DanielaS99/Biomag/Plans/Schematic.png

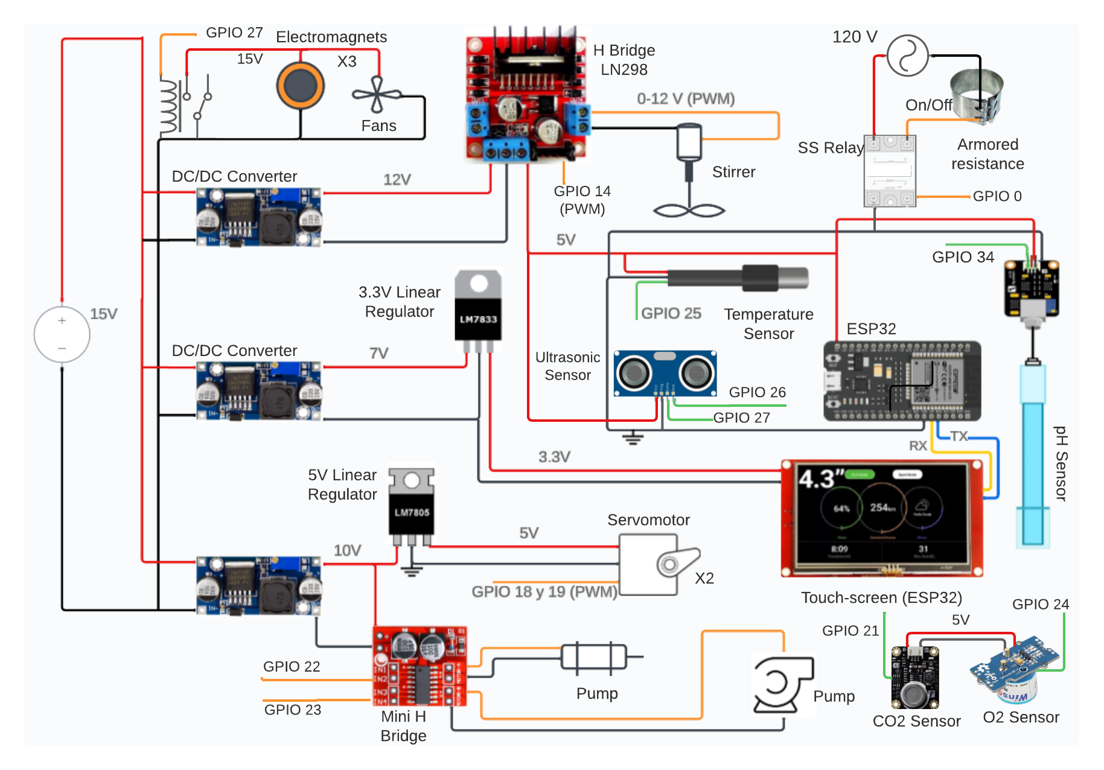
Plans/Schematic.png
