DanielaS99/Biomag/Plans/Coupling.pdf

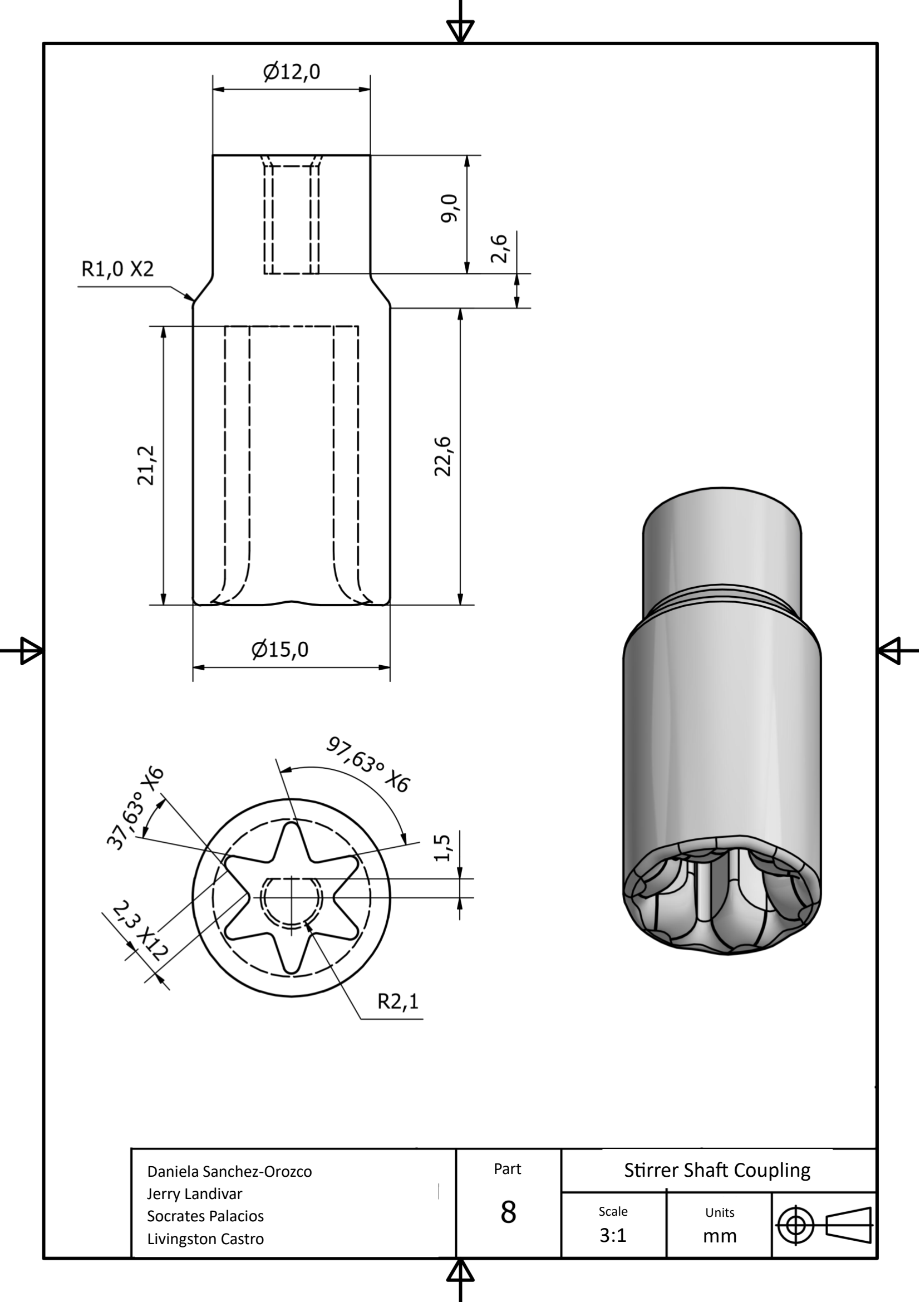
[picture p2: page 1]

Daniela Sanchez

-Orozco
Jerry Landivar
Socrates Palacios
Livingston Castro
Part | Stirrer Shaft Coupling
| Scale 3:1 Units mm
