DanielaS99/Biomag/Plans/Rack_Casing.pdf

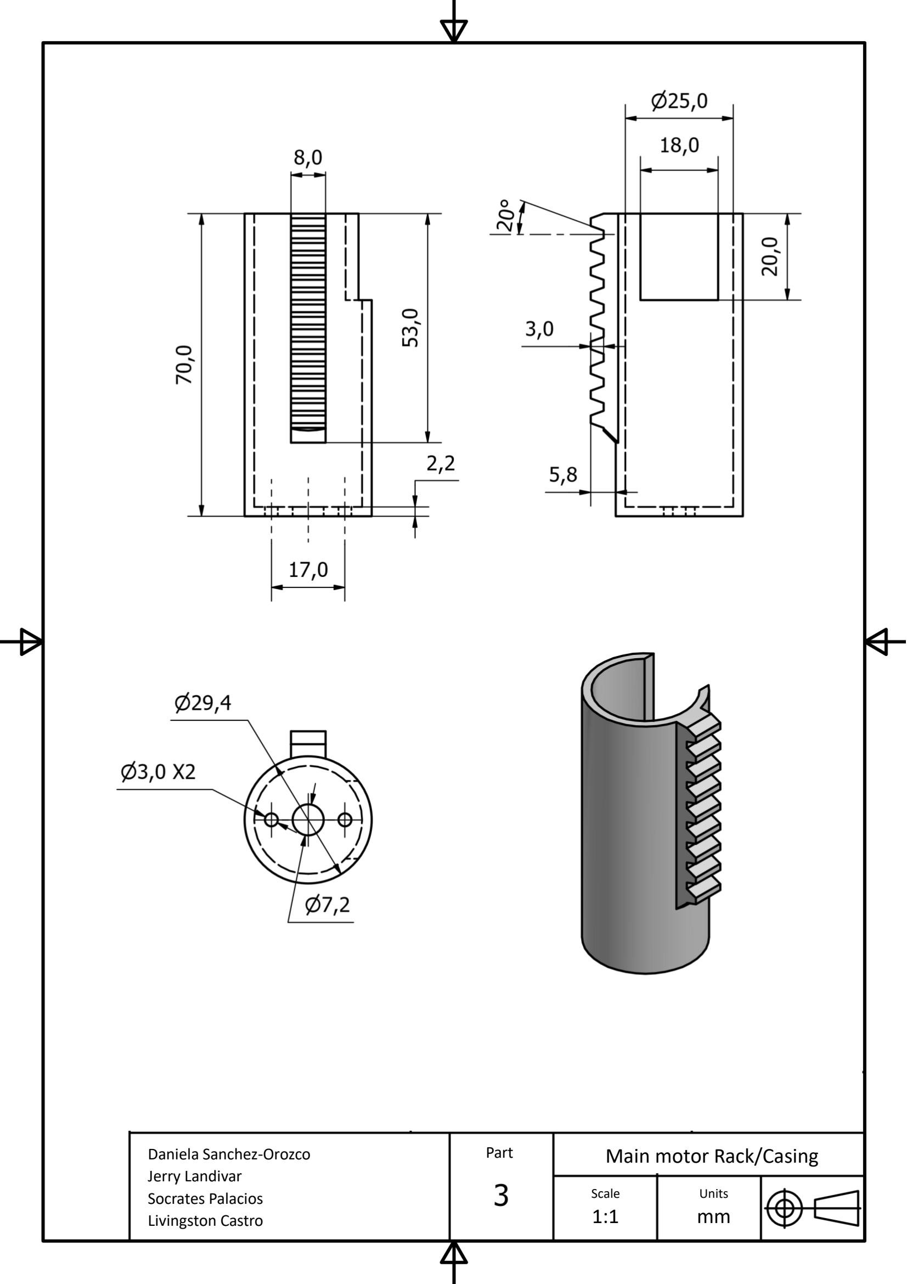
[picture p3: page 1]

Daniela Sanchez

-Orozco
Jerry Landivar
Socrates Palacios
Livingston Castro
Part | Main motor Rack/Casing
| Scale 1:
| 1 Units mm
