DanielaS99/Biomag/Plans/SafetyGuard2.pdf

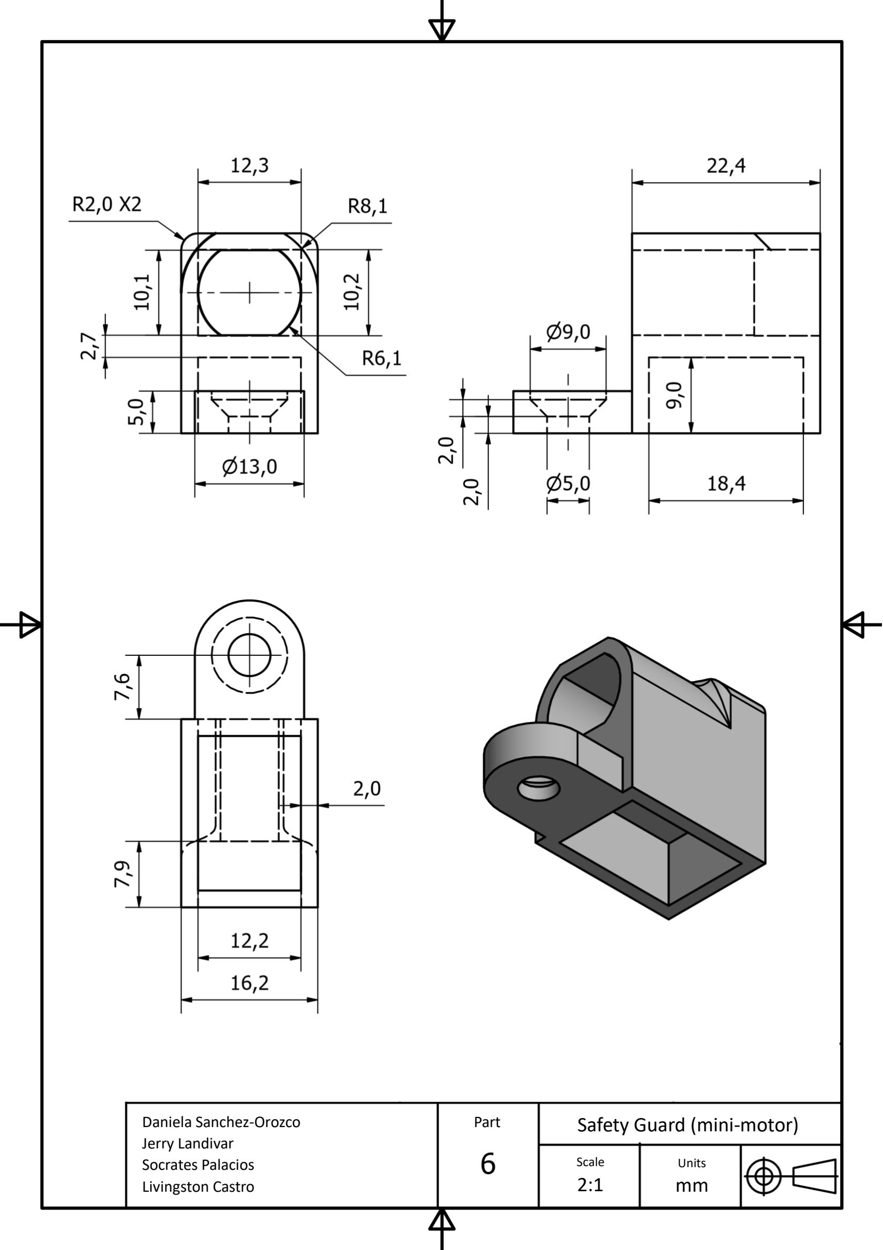
[picture p4: page 1]

Daniela Sanchez

-Orozco
Jerry Landivar
Socrates Palacios
Livingston Castro
Part | Safety Guard (mini

### -motor)

| Scale 2:1 Units mm
