DanielaS99/Biomag/Plans/ServomotorHolder.pdf

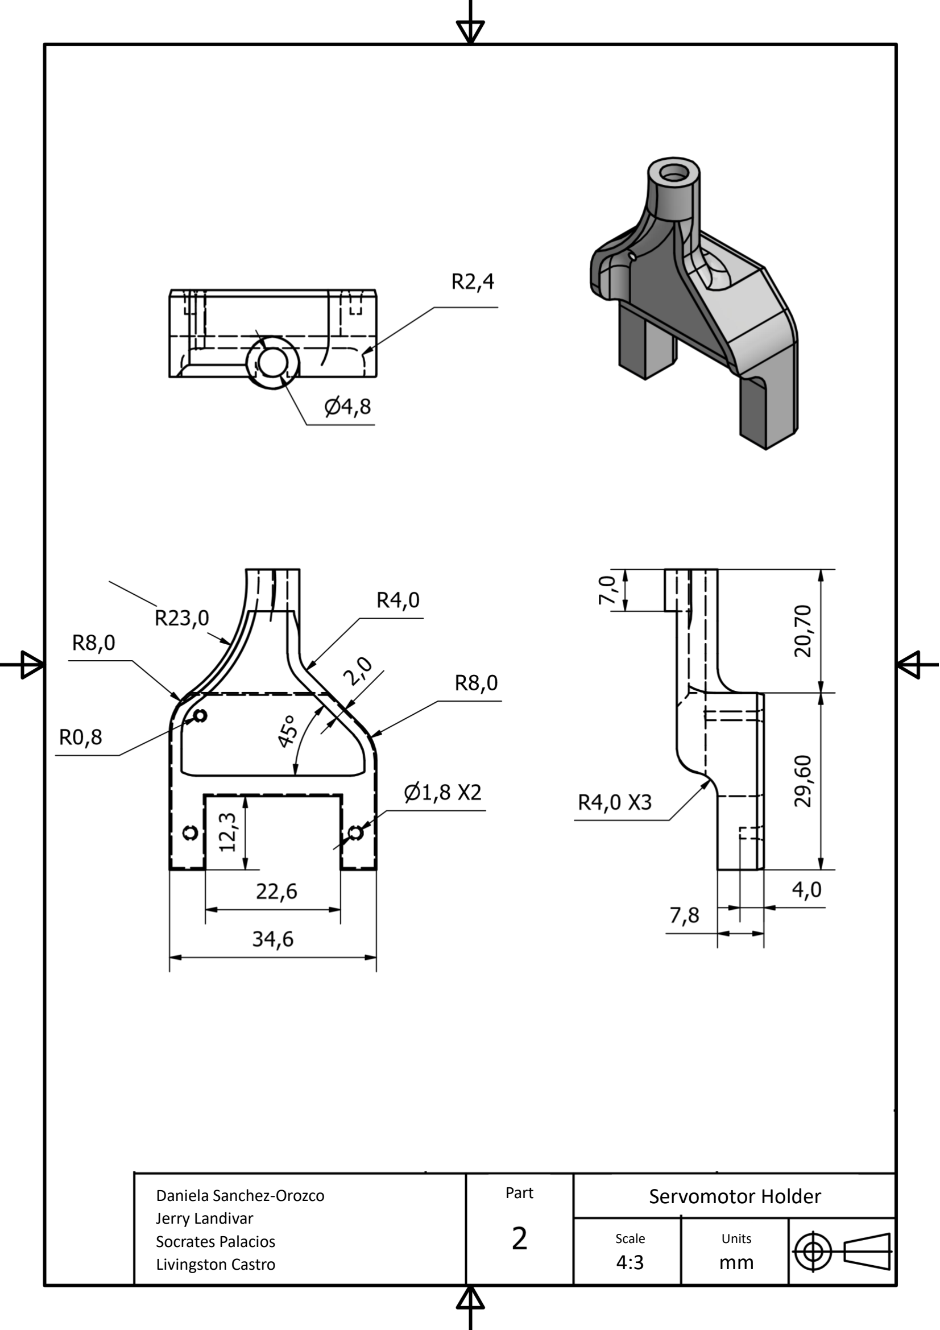
[picture p5: page 1]

Daniela Sanchez

-Orozco
Jerry Landivar
Socrates Palacios
Livingston Castro
Part | Servomotor Holder

Scale
4:3
| Units mm
