DanielaS99/Biomag/Plans/StirrerShaft.pdf

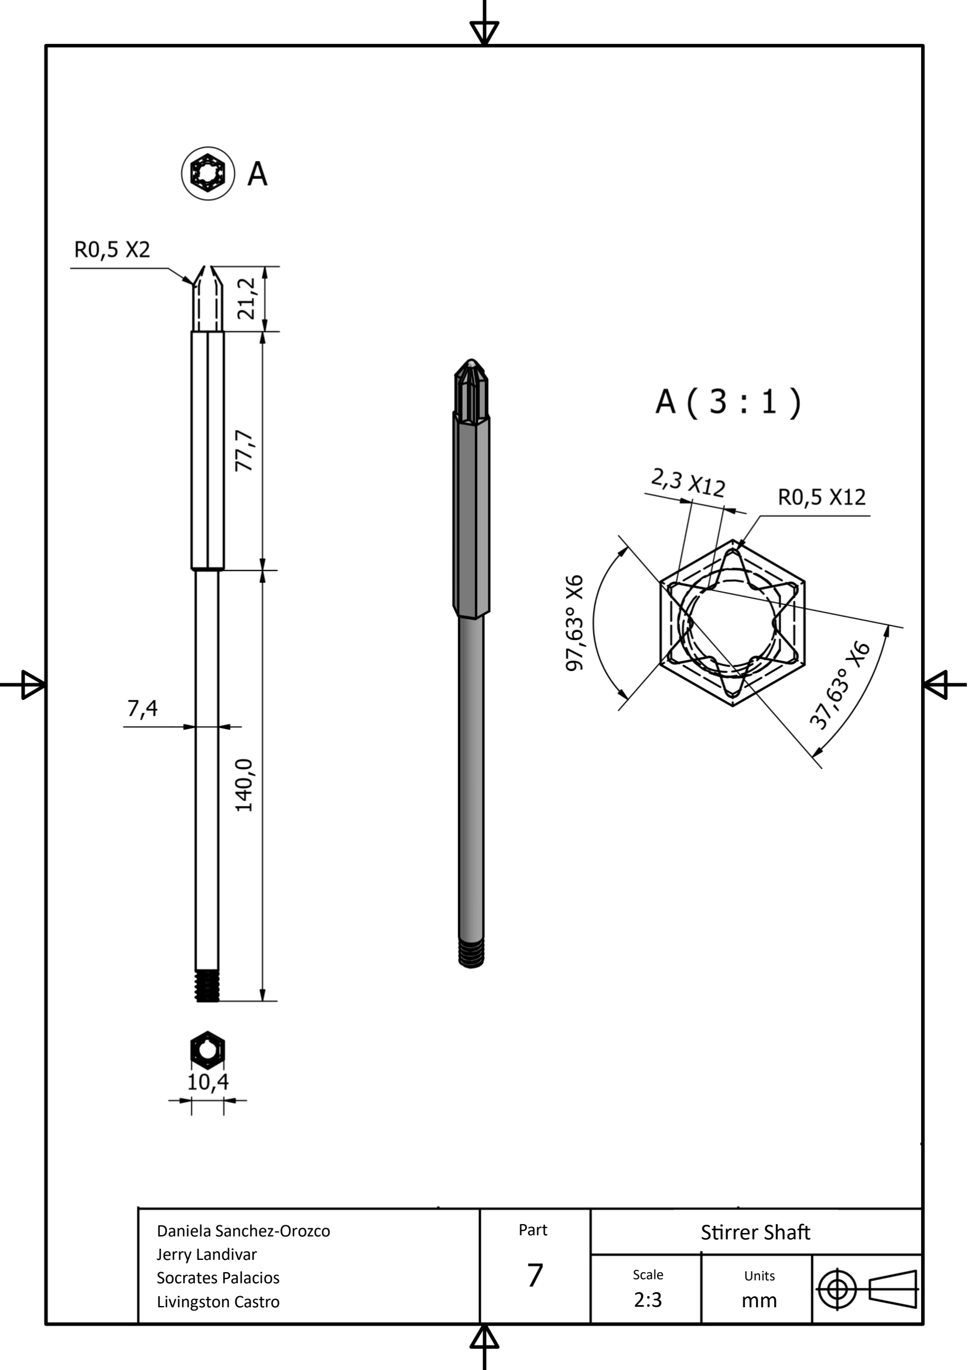
[picture p6: page 1]

Daniela Sanchez

-Orozco
Jerry Landivar
Socrates Palacios
Livingston Castro

Part

### Stirrer Shaft

Scale
2:3

Units
mm
