DanielaS99/Biomag/Plans/ThrottleCam.pdf

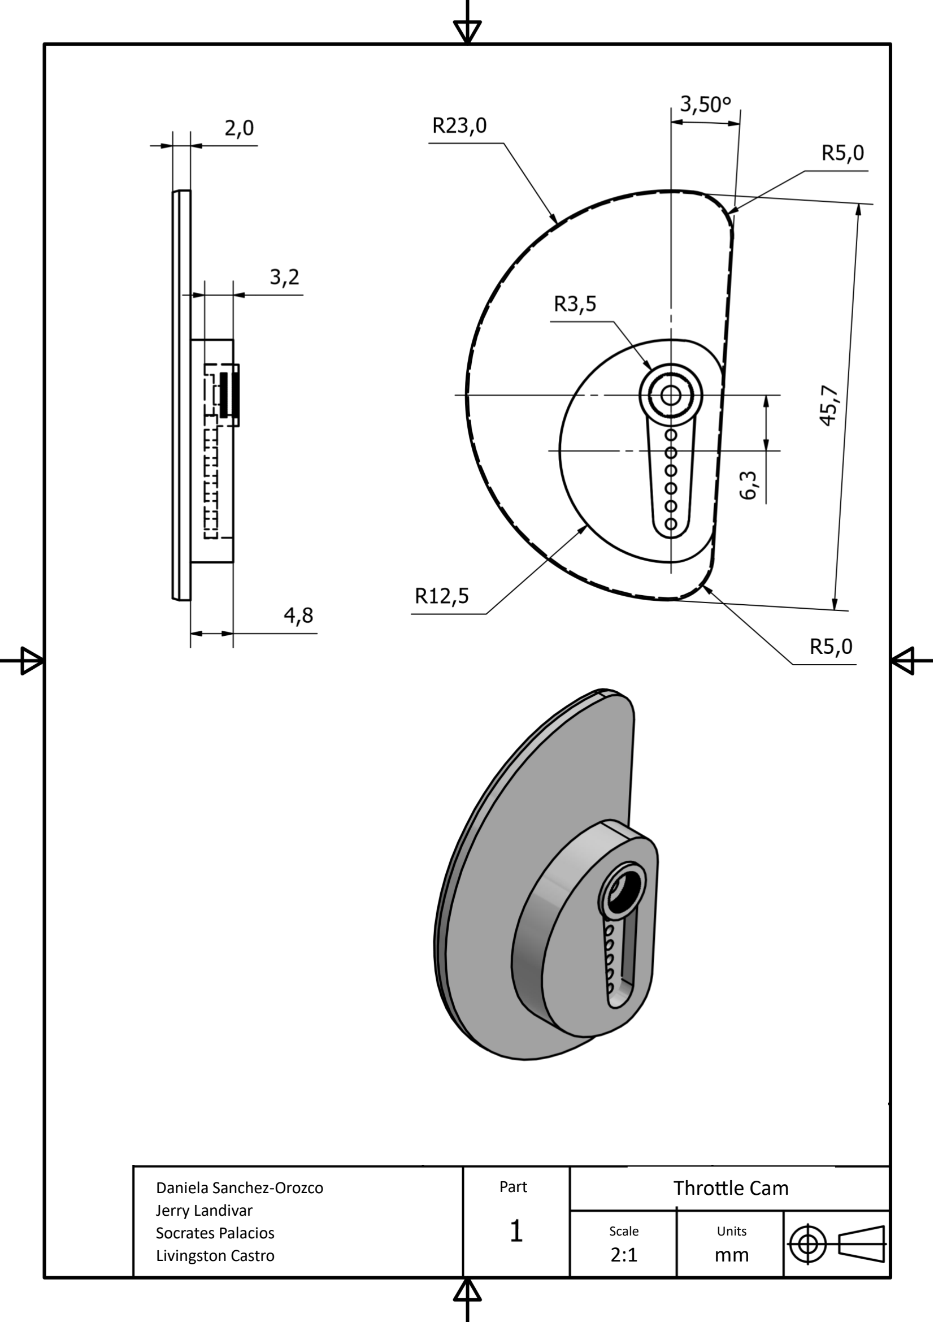
[picture p7: page 1]

Daniela Sanchez

-Orozco
Jerry Landivar
Socrates Palacios
Livingston Castro
Part | Throttle Cam

Scale
2:1
| Units mm
