DanielaS99/Biomag/Plans/Biomag1.pdf

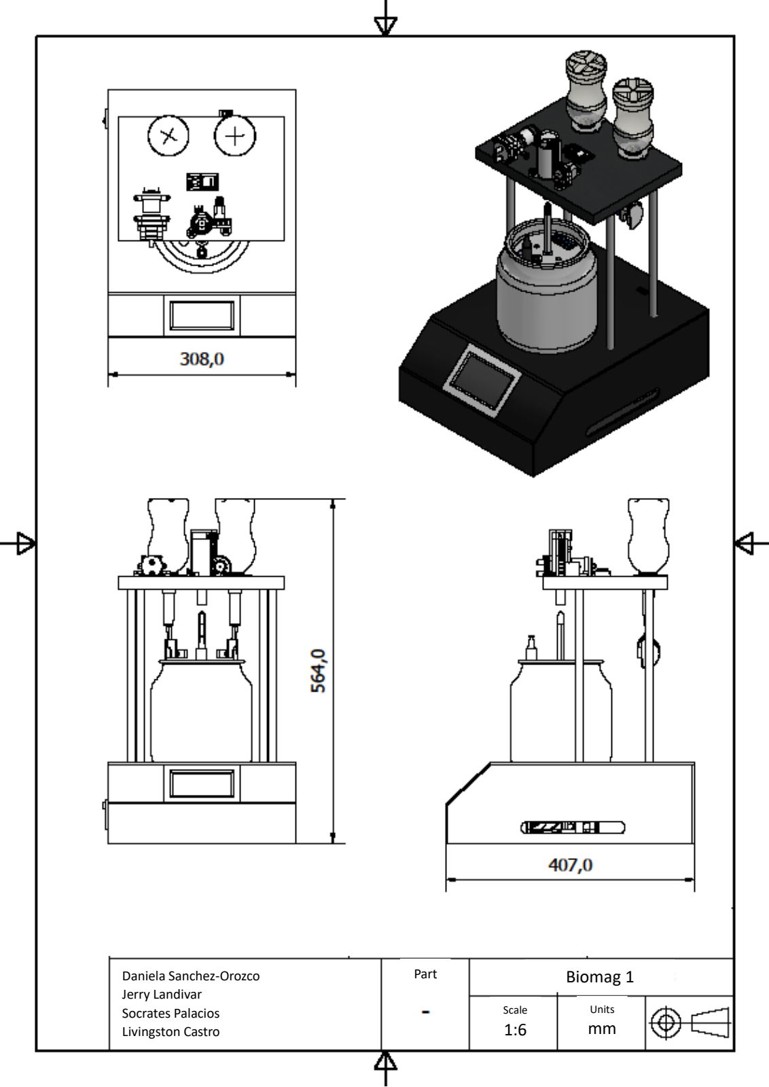
[picture p8: page 1]

Daniela Sanchez

-Orozco
Jerry Landivar
Socrates Palacios
Livingston Castro
Part | Biomag 1

Scale
1:

6

| Units mm
