DanielaS99/Biomag/Plans/Pinion.pdf

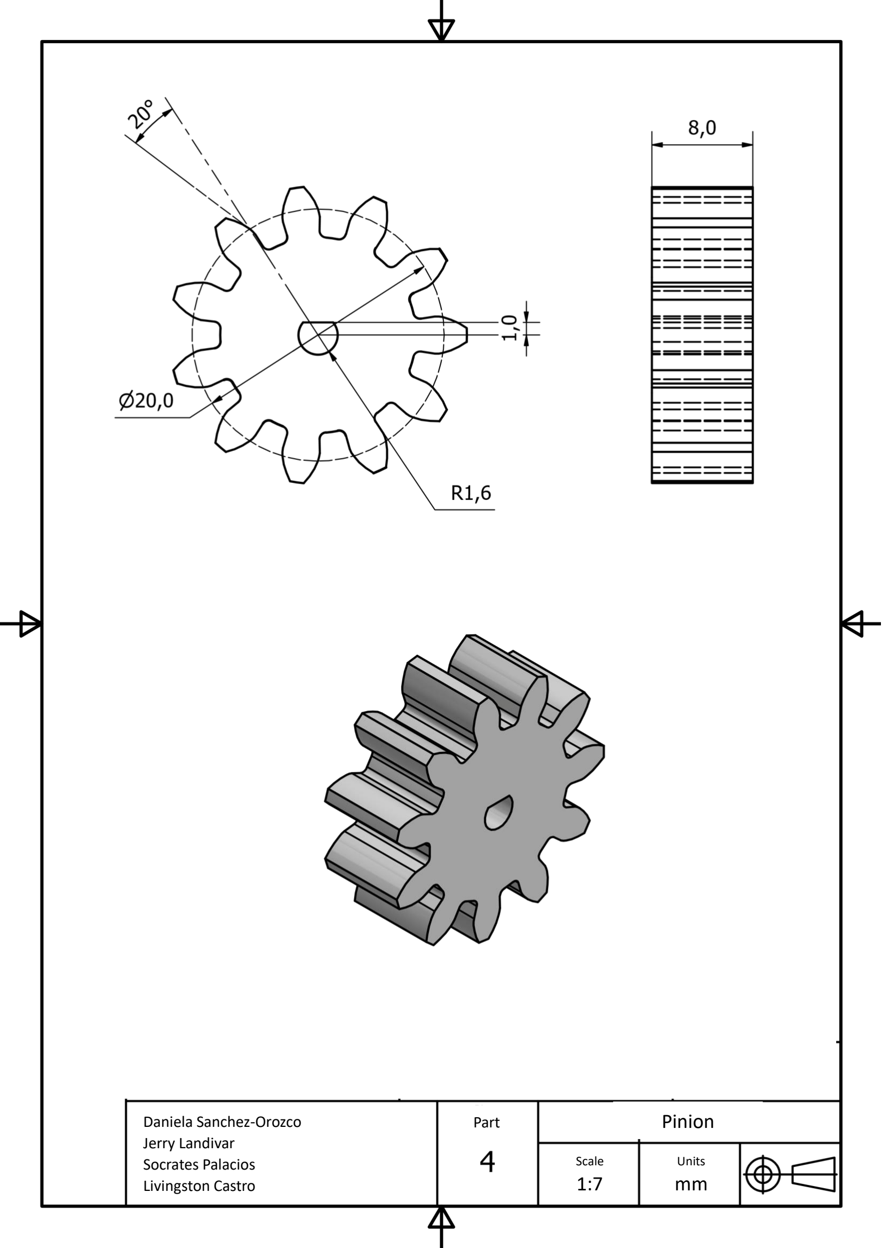
[picture p9: page 1]

Daniela Sanchez

-Orozco
Jerry Landivar
Socrates Palacios
Livingston Castro
Part | Pinion

Scale
1:7
| Units mm
