DanielaS99/Biomag/Plans/SafetyGuard1.pdf

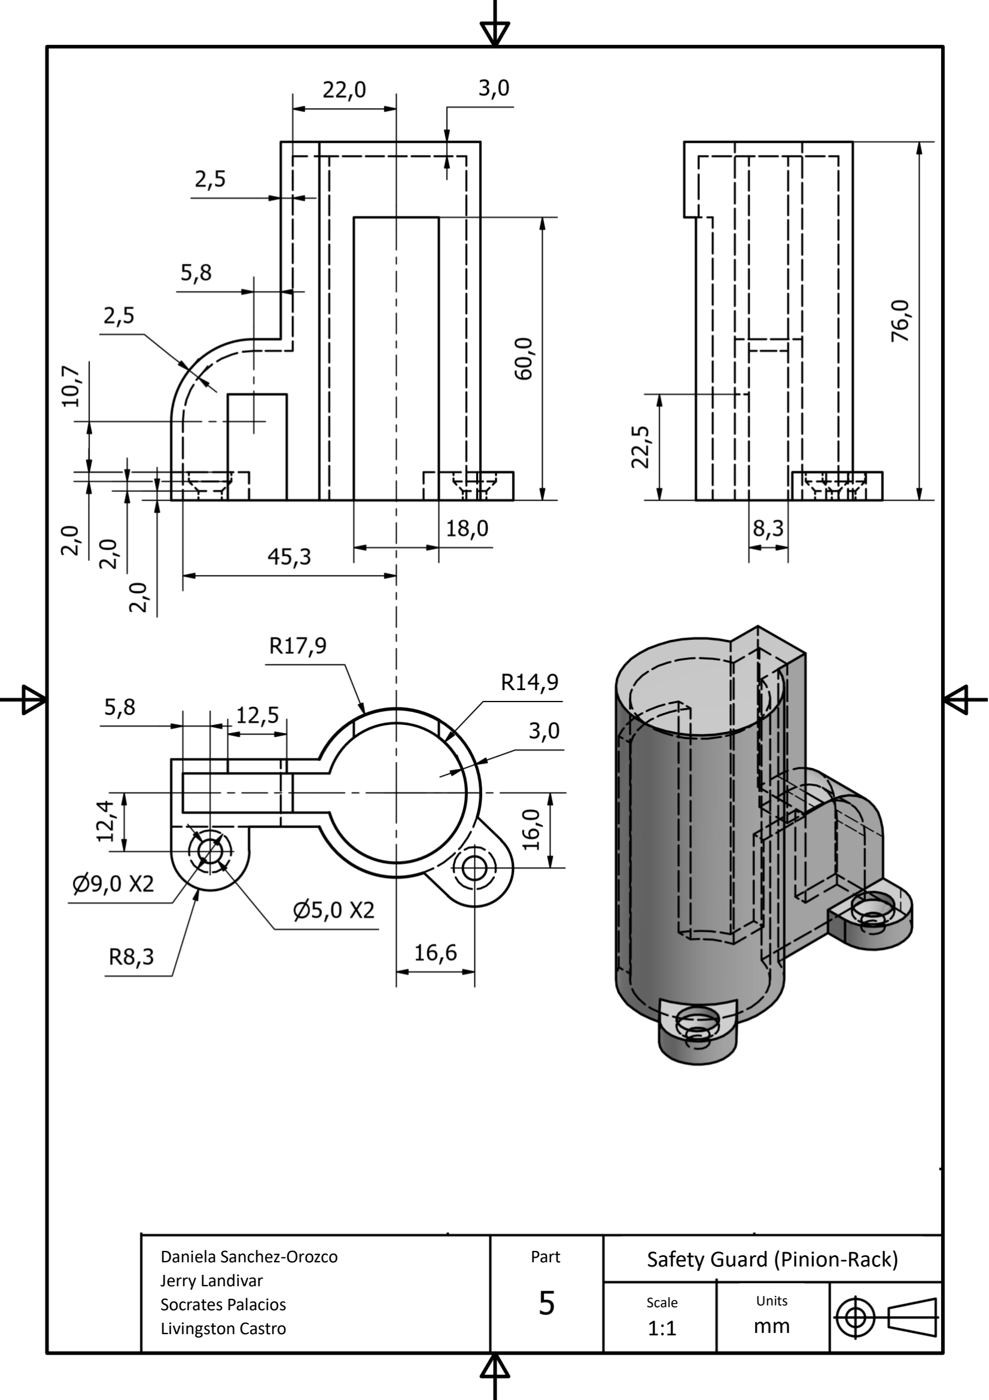
[picture p10: page 1]

Daniela Sanchez

-Orozco
Jerry Landivar
Socrates Palacios
Livingston Castro

Part

Scale
1:

1

### Safety Guard (Pinion

### -Rack)

Units
mm
