DanielaS99/Biomag/Plans/1PartList.pdf

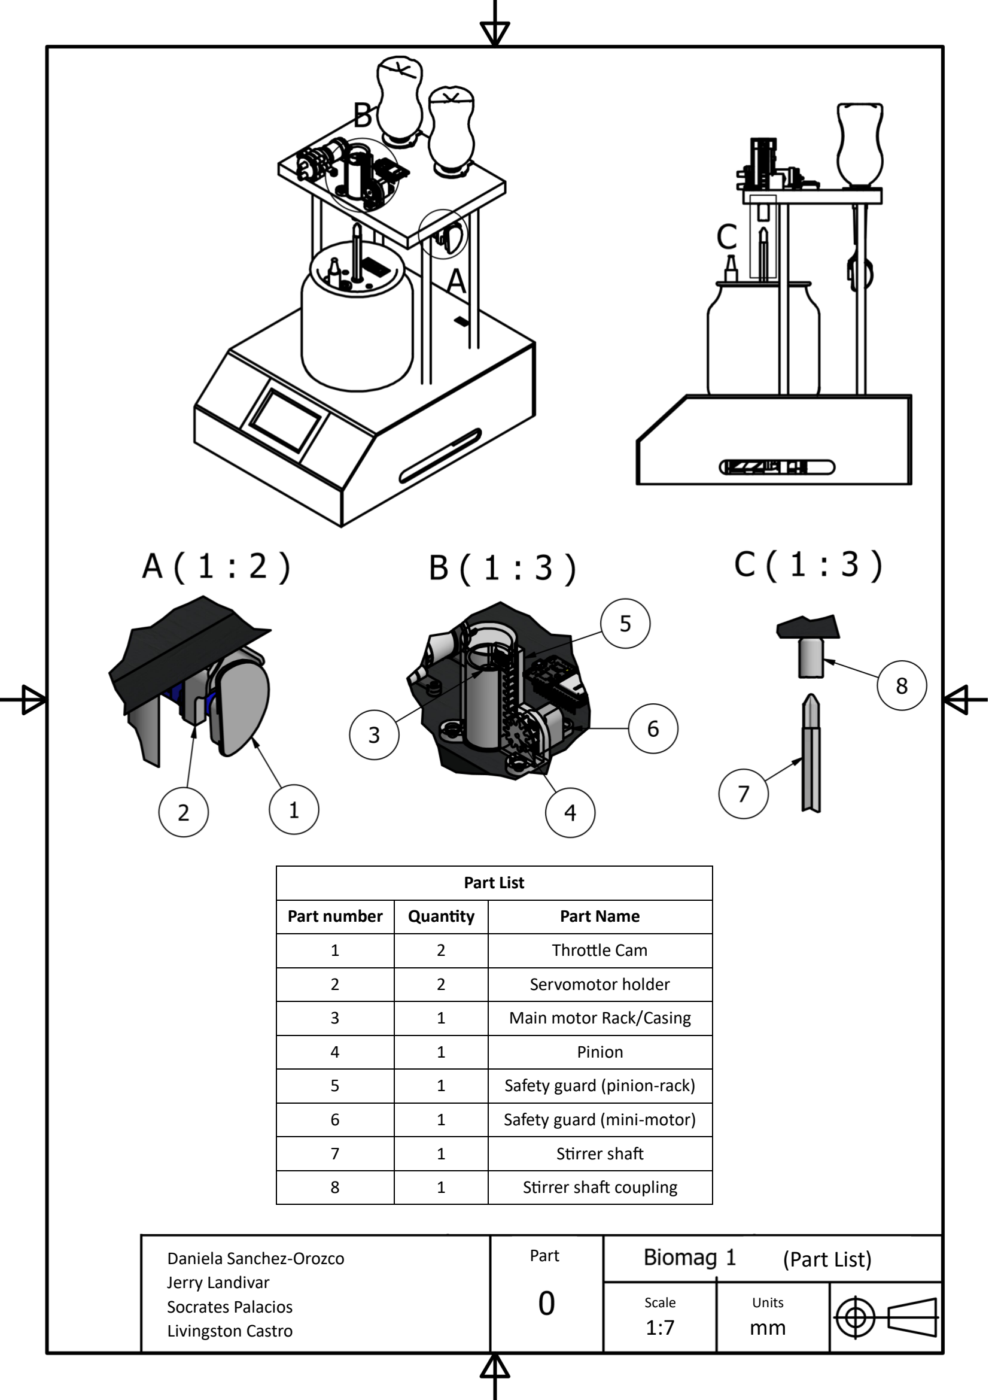
[picture p11: page 1]

Daniela Sanchez-Orozco
Jerry Landivar
Socrates Palacios
Livingston Castro

Part

Scale
1:7

Units
mm

### (Part List)

Part List

Part number | Quantity | Part Name
1 | 2 | Throttle Cam
2 | 2 | Servomotor holder
3 | 1 | Main motor Rack/Casing
4 | 1 | Pinion
5 | 1 | Safety guard (pinion-rack)
6 | 1 | Safety guard (mini-motor)
7 | 1 | Stirrer shaft
8 | 1 | Stirrer shaft coupling
