DanielaS99/Biomag/(commit log)

2024-10-21 Add files via upload
    Simulation to visualize the air flow for the electromagnets cooling system.
2024-10-21 Add files via upload
    Simulation to visualize the air flow in the electromagnet's cooling system
2024-10-22 Add files via upload
    Simulation of the steps to disassemble the device for cleaning
2024-10-22 Add files via upload
    Discharge simulation (magnetic field on)
2024-10-22 Add files via upload
    ESP32 code to control Temperature, pH, Stirring and Magnetic field
2024-10-22 Add files via upload
    Main python code to model the magnetic Field
2024-10-22 Update and rename Codes/main.py to Codes/MagneticField/main.py
2024-10-22 Add files via upload
    Magnetic Field mathematical model
2024-10-22 Add files via upload
    Electronic schematic diagram
